ringo47/Spheron/README.md

# Spheron - A BB-8 inspired autonomous spherical rolling robot.
[Video and more](https://ringo47.github.io/#page-portfolio)
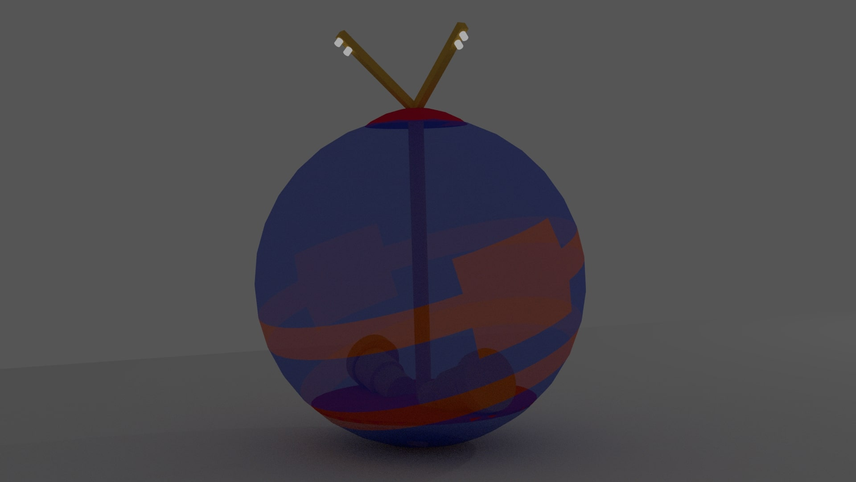
[picture p1: spheron.jpg]
annonated
